sivamacharla/harness_tester_challenge/(commit log)

2026-07-13 Add bug analysis for harness tester challenge
    Documents 25 verified bugs found across firmware, schematic, and PCB
    layout, backed by DRC/ERC reports and the exported schematic netlist.
2026-07-13 Fix firmware and schematic bugs from harness tester challenge
    Firmware (firmware.ino, CY8C9560.*):
    - Fix inverted start-button logic
    - Fix pass/fail logic (require all 40 pins to match, not just one)
    - Fix 32-bit shift overflow in per-pin bitmask calculation
    - Fix expander bit-to-harness-pin mapping (bits 20-23 are SCL/SDA, not GPIO)
    - Add missing pinMode(OUTPUT) for GPS SAFEBOOT/RESET lines
    - Add bounds check on NMEA receive buffer
    - Fix CY8C9560 reset sequence to actually release RESET_N before I2C use
    - Add I2C error tracking to the CY8C9560 driver
    - Add debounce/single-shot logic so a test only runs once per button press
    Schematic (hardware_challenge.kicad_sch):
    - Fix R3 (I2C SDA pull-u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
    [hardware_challenge.kicad_sch]
